tobycm/usb-charging-hub/usb-charging-hub.kicad_pcb

## KiCad design usb-charging-hub.kicad_pcb (2025-05-26)

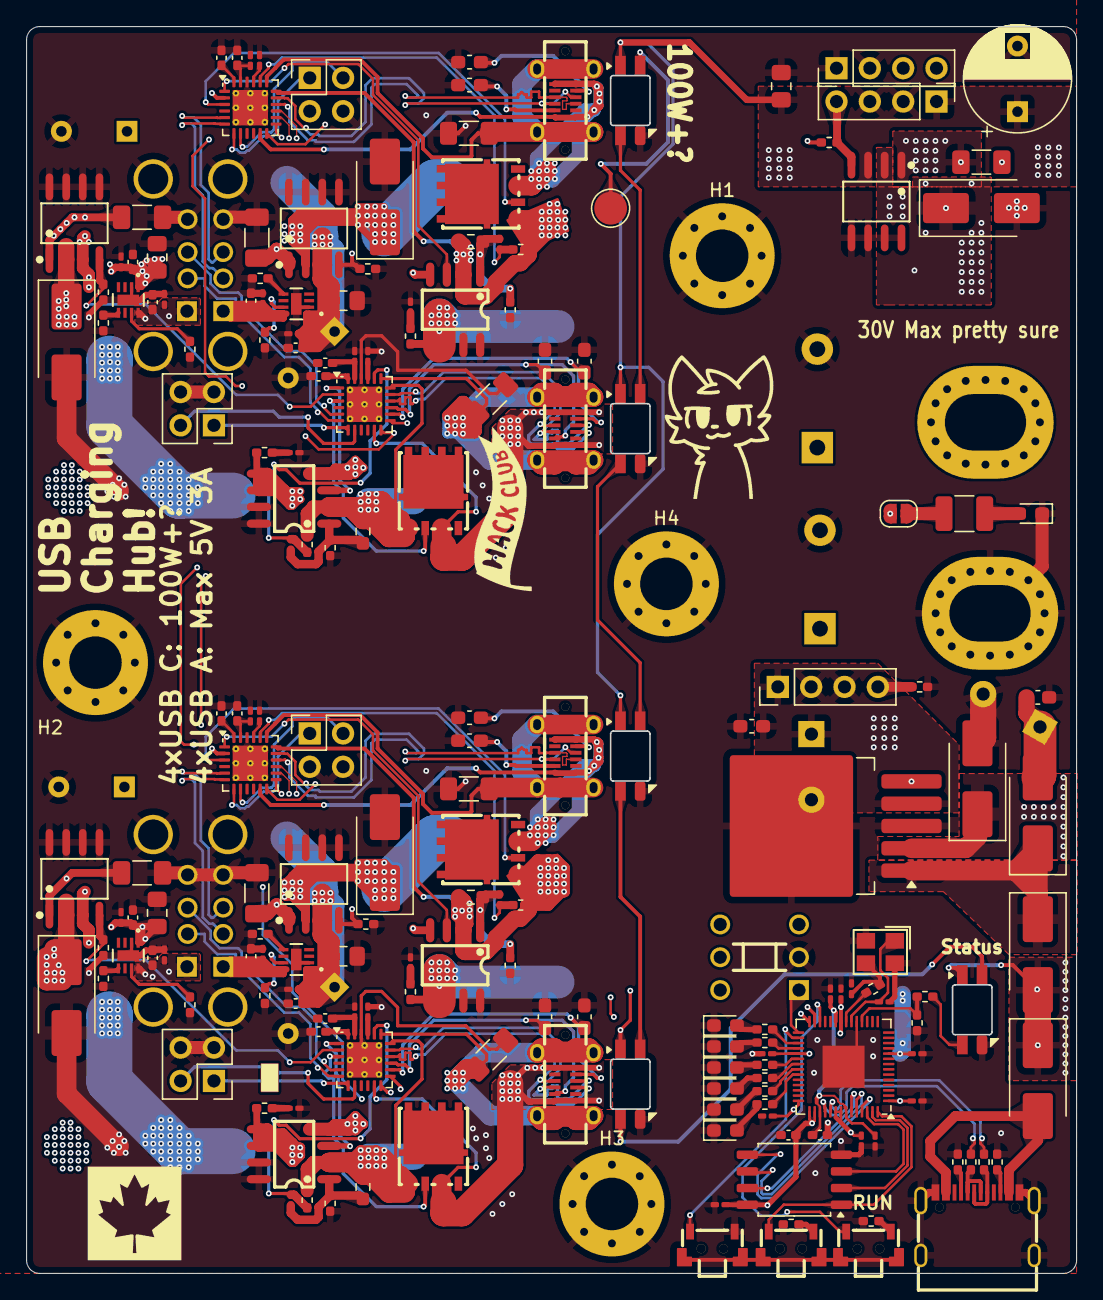
[picture p16: board usb-charging-hub.kicad_pcb from above]

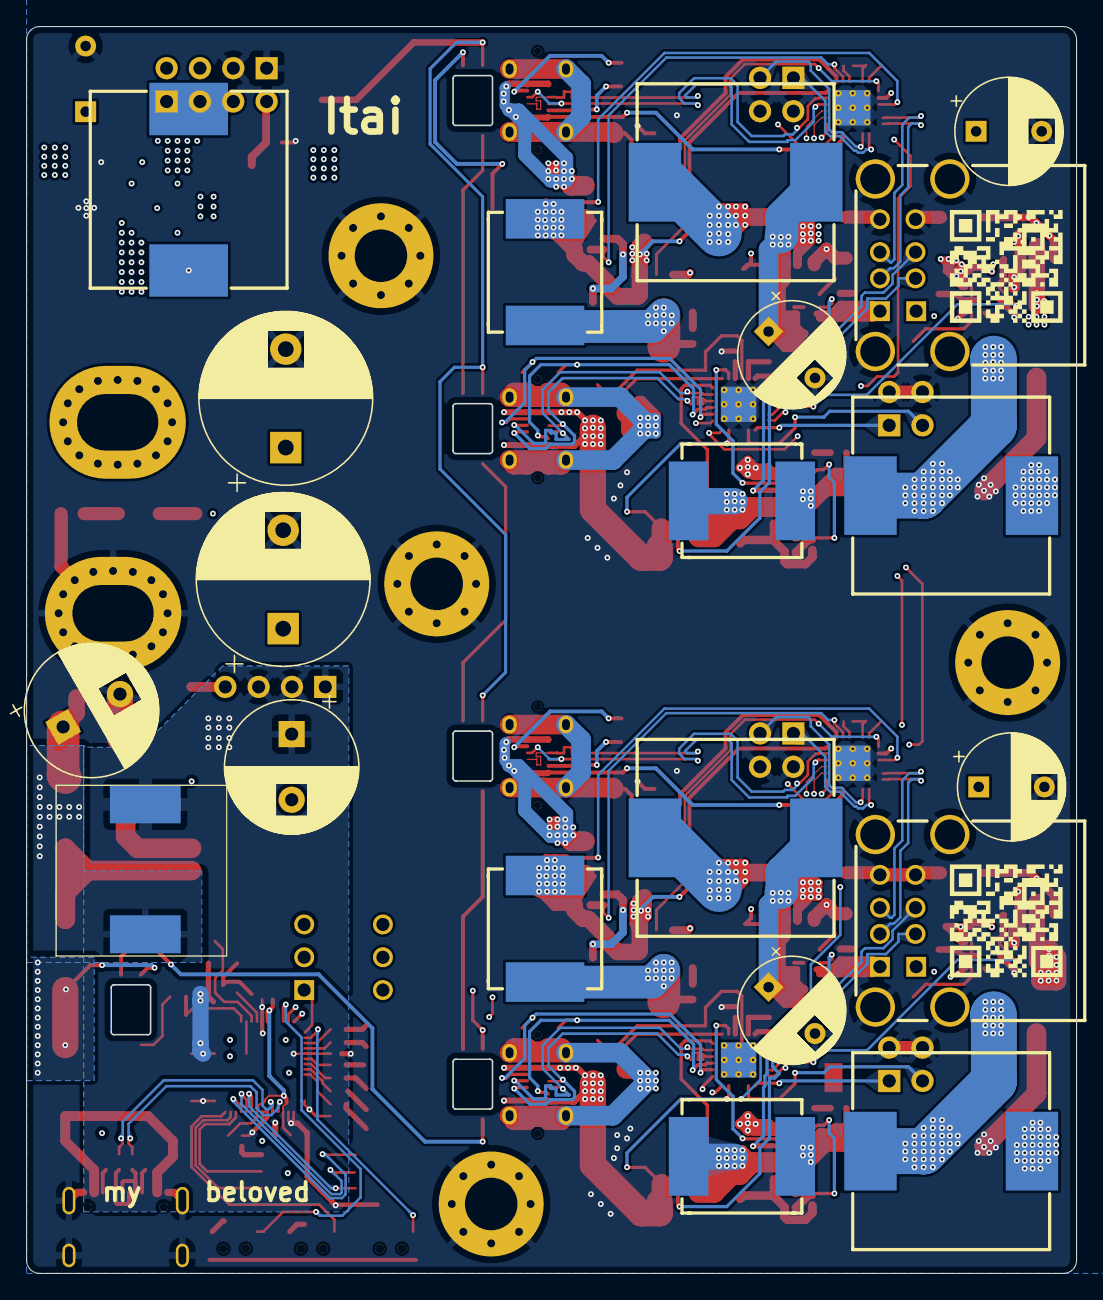
[picture p17: board usb-charging-hub.kicad_pcb from below]

Board: 4 copper layers, 80.0 x 95.0 mm, 214 parts (20 on the bottom side), 159 nets.

Parts:
C1, C2: 50V,1000uF; CP_Radial_D13.0mm_P7.50mm
C3, C4, C5, C7, C8, C9, C10, C11, C12, C29, C36, C38, C40, C42, C44, C45, C52, C59, C66, C68, C70, C72, C74, C75, C82: 100nF; C_0201_0603Metric_Pad0.64x0.40mm_HandSolder
C6, C13, C30, C31, C37, C39, C41, C43, C46, C47, C60, C61, C67, C69, C71, C73, C76, C77: 1uF; C_0402_1005Metric_Pad0.74x0.62mm_HandSolder
C14, C15: 18pF; C_0201_0603Metric_Pad0.64x0.40mm_HandSolder
C16: 50V,470uF; CP_Radial_D10.0mm_P5.00mm
C17: 50V,1uF; C_0603_1608Metric_Pad1.08x0.95mm_HandSolder
C18: 35V,470uF; CP_Radial_D10.0mm_P5.00mm
C19: 10V,10uF; C_0603_1608Metric_Pad1.08x0.95mm_HandSolder
C20, C23, C24, C53, C54: 50V,10uF; C_1206_3216Metric_Pad1.33x1.80mm_HandSolder
C21, C25, C27, C55, C57: 35V,180uF; CP_Radial_D8.0mm_P5.00mm
C22, C26, C28, C56, C58: 35V,22uF; C_0805_2012Metric_Pad1.18x1.45mm_HandSolder
C32, C33, C48, C49, C62, C63, C78, C79: 390pF 5% X7R; C_0603_1608Metric_Pad1.08x0.95mm_HandSolder
C34, C50, C64, C80: 100pF; C_0201_0603Metric_Pad0.64x0.40mm_HandSolder
C35, C51, C65, C81: 1nF; C_0201_0603Metric_Pad0.64x0.40mm_HandSolder
D1: LED; LED_0603_1608Metric_Pad1.05x0.95mm_HandSolder
D2, D3: Green; LED_0603_1608Metric_Pad1.05x0.95mm_HandSolder
D4, D9, D11, D12, D13, D14, D15, D16: 40V,10A; D_SMB_Handsoldering
D5, D6: Amber; LED_0603_1608Metric_Pad1.05x0.95mm_HandSolder
D7, D8: Red; LED_0603_1608Metric_Pad1.05x0.95mm_HandSolder
D10: 60V,10A; D_SMB_Handsoldering
H1, H2, H3, H4: MountingHole_Pad; MountingHole_4mm_Pad_Via
J1, J2: Conn_01x01_Pin; MountingHole_4.3x6.2mm_M4_Pad_Via
J4, J6, J7: Conn_01x04_Pin; PinHeader_1x04_P2.54mm_Vertical
J8, J11, J13, J16: TYPE-C 16PLT-H10.0; TYPE-C-SMD_USB4120-03-C
J9, J12, J14, J17: Conn_01x04_Pin; PinHeader_2x02_P2.54mm_Vertical
J10, J15: XDUF-0426-081_C18202150; USB-A-TH_XDUF-0426-081
J35: GT-USB-7010ASV; USB-C-SMD_G-SWITCH_GT-USB-7010ASV
JP1: SolderJumper_2_Open; SolderJumper-2_P1.3mm_Open_RoundedPad1.0x1.5mm
L1: 33uH,4.25A; SDRI129-330MT
L2, L3, L4, L7, L8: YPRH1508-680M; IND-SMD_L15.0-W15.0
L5, L6, L9, L10: 6.8uH,5.2A,8A(Isat); IND-SMD_L8.0-W8.0-1
LED1, LED2, LED3, LED4, LED5: SK6812MINI-E_C5149201; SK6812-MINI-E
Q1, Q2, Q3, Q4: PMOS; PDFN-8_L5.2-W5.9-P1.27-LS6.2-BL
R1: 1.5k; R_1210_3225Metric_Pad1.30x2.65mm_HandSolder
R2, R3: 5.1k; R_0402_1005Metric_Pad0.72x0.64mm_HandSolder
R4, R5: 27; R_0402_1005Metric_Pad0.72x0.64mm_HandSolder
R6, R11, R16, R22, R31, R38, R47: 1k; R_0402_1005Metric_Pad0.72x0.64mm_HandSolder
R9, R10, R12, R13, R14, R15, R107: 470; R_0402_1005Metric_Pad0.72x0.64mm_HandSolder
R17, R18, R19, R20, R35, R36: 100k; R_0402_1005Metric_Pad0.72x0.64mm_HandSolder
R21, R30, R37, R46: 40k; R_0603_1608Metric_Pad0.98x0.95mm_HandSolder
R23, R32, R39, R48: 6.8; R_0402_1005Metric_Pad0.72x0.64mm_HandSolder
R24, R27, R29, R33, R40, R43, R45, R49, R108: 10k; R_0402_1005Metric_Pad0.72x0.64mm_HandSolder
R25, R34, R41, R50: 5mOhm 1% Shunt; R_1206_3216Metric_Pad1.30x1.75mm_HandSolder
R26, R28, R42, R44: 249k; R_0402_1005Metric_Pad0.72x0.64mm_HandSolder
SW1, SW3, SW4: TS24CA; SW-SMD_TS24CA
SW2: Latching; SW-TH_6P-L8.0-W8.0-P2.50
TP1: TestPoint; TestPoint_Pad_D2.5mm
U1: W25Q32JVSS; SOIC-8_5.3x5.3mm_P1.27mm
U2: ABM8-272-T3_C20625731; CRYSTAL-SMD_4P-L3.2-W2.5-BL
U3: RP2040; QFN-56-1EP_7x7mm_P0.4mm_EP3.2x3.2mm
U4: LM2596S-3.3; TO-263-5_TabPin3
U5, U6, U7, U14, U15: XXL1509-5.0; SOIC-8_L4.9-W3.9-P1.27-LS6.0-BL
U8, U12, U16, U20: NDP23511KC; SOP-8_L4.9-W3.9-P1.27-LS6.0-BL
U9, U13, U17, U21: CYPD3175-24LQXQ; QFN-24-1EP_4x4mm_P0.5mm_EP2.7x2.7mm_ThermalVias
U10, U11, U18, U19: LS0505EVD22; LS0505EVD22_LTF

Connections:
3.3V_BUCK_EN: J4.4, R17.2, U4.5 (~ON/OFF)
5V_BUCK_EN: J6.4, R18.2, U5.4 (EN)
+1V1: C4.2, C5.2, C6.2, U3.23 (DVDD), U3.45 (VREG_VOUT), U3.50 (DVDD)
+3.3V: C3.2, C7.2, C8.2, C9.2, C10.2, C11.2, C12.2, C13.2, C18.1, C19.1, J4.1, J4.2, J4.3, L1.2, U1.8 (VCC), U3.1 (IOVDD), U3.10 (IOVDD), U3.22 (IOVDD), U3.33 (IOVDD), U3.42 (IOVDD), U3.43 (ADC_AVDD), U3.44 (VREG_IN), U3.48 (USB_VDD), U3.49 (IOVDD), U4.4 (FB)
+5V: C21.1, C22.1, D4.1 (K), D9.2 (A), J6.1, J6.2, J6.3, L2.2, LED1.1 (VDD), LED2.1 (VDD), LED3.1 (VDD), LED4.1 (VDD), LED5.1 (VDD), U5.3 (FB)
/USB 1/1_BUCK_EN: U8.3 (EN), U9.1 (P1.0)
/USB 1/1_D+: J8.A6 (DP1), J8.B6 (DP2), U9.17 (DP0/P3.0)
/USB 1/1_D-: J8.A7 (DN1), J8.B7 (DN2), U9.16 (DM0/P3.1)
/USB 1/2_BUCK_EN: U12.3 (EN), U13.1 (P1.0)
/USB 1/2_D+: J11.A6 (DP1), J11.B6 (DP2), U13.17 (DP0/P3.0)
/USB 1/2_D-: J11.A7 (DN1), J11.B7 (DN2), U13.16 (DM0/P3.1)
/USB 1/D_5V: C27.1, C28.1, C43.2, C44.2, L4.2, U7.3 (FB), U11.1 (IN)
/USB 1/D_BUCK_EN: R20.2, U7.4 (EN), U13.2 (P1.1)
/USB 1/D_D+: J10.7 (D-D+), U13.5 (DP1/P1.2)
/USB 1/D_D-: J10.6 (D-D-), U13.6 (DM1/P1.3)
/USB 1/D_EN: R29.1, U11.5 (EN)
/USB 1/U_5V: C25.1, C26.1, C39.2, C40.2, L3.2, U6.3 (FB), U10.1 (IN)
/USB 1/U_BUCK_EN: R19.2, U6.4 (EN), U9.2 (P1.1)
/USB 1/U_D+: J10.3 (U-D+), U9.5 (DP1/P1.2)
/USB 1/U_D-: J10.2 (U-D-), U9.6 (DM1/P1.3)
/USB 1/U_EN: R27.1, U10.5 (EN)
/USB 2/1_BUCK_EN: U16.3 (EN), U17.1 (P1.0)
/USB 2/1_D+: J13.A6 (DP1), J13.B6 (DP2), U17.17 (DP0/P3.0)
/USB 2/1_D-: J13.A7 (DN1), J13.B7 (DN2), U17.16 (DM0/P3.1)
/USB 2/2_BUCK_EN: U20.3 (EN), U21.1 (P1.0)
/USB 2/2_D+: J16.A6 (DP1), J16.B6 (DP2), U21.17 (DP0/P3.0)
/USB 2/2_D-: J16.A7 (DN1), J16.B7 (DN2), U21.16 (DM0/P3.1)
/USB 2/D_5V: C57.1, C58.1, C73.2, C74.2, L8.2, U15.3 (FB), U19.1 (IN)
/USB 2/D_BUCK_EN: R36.2, U15.4 (EN), U21.2 (P1.1)
/USB 2/D_D+: J15.7 (D-D+), U21.5 (DP1/P1.2)
/USB 2/D_D-: J15.6 (D-D-), U21.6 (DM1/P1.3)
/USB 2/D_EN: R45.1, U19.5 (EN)
/USB 2/U_5V: C55.1, C56.1, C69.2, C70.2, L7.2, U14.3 (FB), U18.1 (IN)
/USB 2/U_BUCK_EN: R35.2, U14.4 (EN), U17.2 (P1.1)
/USB 2/U_D+: J15.3 (U-D+), U17.5 (DP1/P1.2)
/USB 2/U_D-: J15.2 (U-D-), U17.6 (DM1/P1.3)
/USB 2/U_EN: R43.1, U18.5 (EN)
/rp2040/USB_D+: R4.2, U3.47 (USB_DP)
/rp2040/USB_D-: R5.2, U3.46 (USB_DM)
/rp2040/USB_R_D+: J35.A6 (DP1), J35.B6 (DP2), R4.1
/rp2040/USB_R_D-: J35.A7 (DN1), J35.B7 (DN2), R5.1
GND: C1.2, C2.2, C3.1, C4.1, C5.1, C6.1, C7.1, C8.1, C9.1, C10.1, C11.1, C12.1, C13.1, C14.1, C15.1, C16.2, C17.2, C18.2, C19.2, C20.2, C21.2, C22.2, C23.2, C24.2, C25.2, C26.2, C27.2, C28.2, C29.1, C30.1, C31.1, C32.2, C33.2, C35.2, C36.2, C37.1, C38.1, C39.1, C40.1, C41.1, C42.1, C43.1, C44.1, C45.1, C46.1, C47.1, C48.2, C49.2, C51.2, C52.2, C53.2, C54.2, C55.2, C56.2, C57.2, C58.2, C59.1, C60.1, C61.1, C62.2, C63.2, C65.2, C66.2, C67.1, C68.1, C69.1, C70.1, C71.1, C72.1, C73.1, C74.1, C75.1, C76.1, C77.1, C78.2, C79.2, C81.2, C82.2, D1.1 (K), D2.1 (K), D3.1 (K), D5.1 (K), D6.1 (K), D7.1 (K), D8.1 (K), D11.2 (A), D12.2 (A), D13.2 (A), D14.2 (A), D15.2 (A), D16.2 (A), H1.1, H2.1, H3.1, H4.1, J2.1, J7.1, J7.2, J9.3, J9.4, J10.4 (U-GND), J10.8 (D-GND), J10.9 (SHELL), J10.10 (SHELL), J10.11 (SHELL), J10.12 (SHELL), J12.3, J12.4, J14.3, J14.4, J15.4 (U-GND), J15.8 (D-GND), J15.9 (SHELL), J15.10 (SHELL), J15.11 (SHELL), J15.12 (SHELL), J17.3, J17.4, J35.1 (SHELL), J35.2 (SHELL), J35.3 (SHELL), J35.4 (SHELL), J35.A1B12 (GND), J35.B1A12 (GND), LED1.3 (GND), LED2.3 (GND), LED3.3 (GND), LED4.3 (GND), LED5.3 (GND), R2.2, R3.2, R11.1, R16.1, R17.1, R18.1, R19.1, R20.1, R24.2, R25.2, R26.2, R27.2, R28.2, R29.2, R33.2, R35.1, R36.1, R40.2, R41.2, R42.2, R43.2, R44.2, R45.2, R49.2, R50.2, R108.2, SW1.1, SW1.2, SW1.3, SW2.2, SW3.1, SW3.2, SW4.1, SW4.2, U1.4 (GND), U2.2 (GND), U2.4 (GND), U3.19 (TESTEN), U3.57 (GND), U4.3 (GND), U5.5 (GND), U5.6 (GND), U5.7 (GND), U5.8 (GND), U6.5 (GND), U6.6 (GND), U6.7 (GND), U6.8 (GND), U7.5 (GND), U7.6 (GND), U7.7 (GND), U7.8 (GND), U8.7 (RT), U8.8 (GND), U9.22 (GND), U9.25 (GND), U10.2 (GND), U10.9 (GND), U11.2 (GND), U11.9 (GND), U12.7 (RT), U12.8 (GND), U14.5 (GND), U14.6 (GND), U14.7 (GND), U14.8 (GND), U15.5 (GND), U15.6 (GND), U15.7 (GND), U15.8 (GND), U16.7 (RT), U16.8 (GND), U17.22 (GND), U17.25 (GND), U18.2 (GND), U18.9 (GND), U19.2 (GND), U19.9 (GND), U20.7 (RT), U20.8 (GND), U21.22 (GND), U21.25 (GND)
unnamed: C14.2, R6.1, U2.3
unnamed: C35.1, R23.2
unnamed: C51.1, R32.2
unnamed: C65.1, R39.2
unnamed: C81.1, R48.2
unnamed: D1.2 (A), R1.2
unnamed: D2.2 (A), R9.2
unnamed: D3.2 (A), R10.2
unnamed: D5.2 (A), R12.2
unnamed: D6.2 (A), R13.2
unnamed: D7.2 (A), R14.2
unnamed: D8.2 (A), R15.2
unnamed: D9.1 (K), D10.1 (K), U4.1 (VIN)
unnamed: D11.1 (K), L1.1, U4.2 (OUT)
unnamed: D12.1 (K), L2.1, U5.2 (OUTPUT)
unnamed: D13.1 (K), L3.1, U6.2 (OUTPUT)
unnamed: D14.1 (K), L4.1, U7.2 (OUTPUT)
unnamed: D15.1 (K), L7.1, U14.2 (OUTPUT)
unnamed: D16.1 (K), L8.1, U15.2 (OUTPUT)
unnamed: C33.1, J8.A5 (CC1), U9.15 (CC1)
unnamed: C32.1, J8.B5 (CC2), U9.14 (CC2)
unnamed: J8.0 (EH), J8.A1 (GND), J8.A12 (GND), J8.B1 (GND), J8.B12 (GND), R25.1, U9.19 (CSP)
unnamed: J9.1, U9.7 (P0.0/SWD_DAT_0)
unnamed: J9.2, U9.8 (P0.1/SWD_CLK_0)
unnamed: C41.2, C42.2, J10.5 (D-VCC), U11.8 (OUT)
unnamed: C37.2, C38.2, J10.1 (U-VCC), U10.8 (OUT)
unnamed: C49.1, J11.A5 (CC1), U13.15 (CC1)
unnamed: C48.1, J11.B5 (CC2), U13.14 (CC2)
unnamed: J11.0 (EH), J11.A1 (GND), J11.A12 (GND), J11.B1 (GND), J11.B12 (GND), R34.1, U13.19 (CSP)
unnamed: J12.1, U13.7 (P0.0/SWD_DAT_0)
unnamed: J12.2, U13.8 (P0.1/SWD_CLK_0)
unnamed: C63.1, J13.A5 (CC1), U17.15 (CC1)
unnamed: C62.1, J13.B5 (CC2), U17.14 (CC2)
unnamed: J13.0 (EH), J13.A1 (GND), J13.A12 (GND), J13.B1 (GND), J13.B12 (GND), R41.1, U17.19 (CSP)
unnamed: J14.1, U17.7 (P0.0/SWD_DAT_0)
unnamed: J14.2, U17.8 (P0.1/SWD_CLK_0)
unnamed: C71.2, C72.2, J15.5 (D-VCC), U19.8 (OUT)
unnamed: C67.2, C68.2, J15.1 (U-VCC), U18.8 (OUT)
unnamed: C79.1, J16.A5 (CC1), U21.15 (CC1)
unnamed: C78.1, J16.B5 (CC2), U21.14 (CC2)
unnamed: J16.0 (EH), J16.A1 (GND), J16.A12 (GND), J16.B1 (GND), J16.B12 (GND), R50.1, U21.19 (CSP)
unnamed: J17.1, U21.7 (P0.0/SWD_DAT_0)
unnamed: J17.2, U21.8 (P0.1/SWD_CLK_0)
unnamed: J35.A5 (CC1), R2.1
unnamed: J35.B5 (CC2), R3.1
unnamed: JP1.1 (A), R1.1
unnamed: L5.1, R23.1, U8.5 (SW), U8.6 (SW)
unnamed: L6.1, R32.1, U12.5 (SW), U12.6 (SW)
unnamed: L9.1, R39.1, U16.5 (SW), U16.6 (SW)
unnamed: L10.1, R48.1, U20.5 (SW), U20.6 (SW)
unnamed: LED1.2 (DOUT), LED2.4 (DIN)
unnamed: LED2.2 (DOUT), LED3.4 (DIN)
unnamed: LED3.2 (DOUT), LED4.4 (DIN)
unnamed: LED4.2 (DOUT), LED5.4 (DIN)
unnamed: LED5.2 (DOUT), TP1.1
unnamed: L5.2, Q1.1 (D), R21.1, R22.1, U8.2 (VSEN), U9.18 (VBUS_IN_DIS)
unnamed: Q1.2 (G), U9.3 (VBUS_P_CTRL)
unnamed: J8.A4 (VBUS), J8.A9 (VBUS), J8.B4 (VBUS), J8.B9 (VBUS), Q1.3 (S), U9.11 (VBUS_C_MON_DIS)
unnamed: L6.2, Q2.1 (D), R30.1, R31.1, U12.2 (VSEN), U13.18 (VBUS_IN_DIS)
unnamed: Q2.2 (G), U13.3 (VBUS_P_CTRL)
unnamed: J11.A4 (VBUS), J11.A9 (VBUS), J11.B4 (VBUS), J11.B9 (VBUS), Q2.3 (S), U13.11 (VBUS_C_MON_DIS)
unnamed: L9.2, Q3.1 (D), R37.1, R38.1, U16.2 (VSEN), U17.18 (VBUS_IN_DIS)
unnamed: Q3.2 (G), U17.3 (VBUS_P_CTRL)
unnamed: J13.A4 (VBUS), J13.A9 (VBUS), J13.B4 (VBUS), J13.B9 (VBUS), Q3.3 (S), U17.11 (VBUS_C_MON_DIS)
unnamed: L10.2, Q4.1 (D), R46.1, R47.1, U20.2 (VSEN), U21.18 (VBUS_IN_DIS)
unnamed: Q4.2 (G), U21.3 (VBUS_P_CTRL)
unnamed: J16.A4 (VBUS), J16.A9 (VBUS), J16.B4 (VBUS), J16.B9 (VBUS), Q4.3 (S), U21.11 (VBUS_C_MON_DIS)
unnamed: R11.2, SW3.3
unnamed: R16.2, SW4.3
unnamed: R34.2, U13.22 (GND), U13.25 (GND)
unnamed: R107.1, R108.1, U3.18 (GPIO15)
unnamed: SW2.1, U3.29 (GPIO18)
unnamed: SW1.4, U3.30 (GPIO19)
unnamed: R9.1, U3.31 (GPIO20)
unnamed: R10.1, U3.32 (GPIO21)
unnamed: R12.1, U3.34 (GPIO22)
unnamed: R13.1, U3.35 (GPIO23)
unnamed: R14.1, U3.36 (GPIO24)
unnamed: R15.1, U3.37 (GPIO25)
unnamed: C34.1, R21.2, R24.1, U8.1 (VFB)
unnamed: C36.1, U9.21 (COMP)
unnamed: C34.2, R22.2, U9.20 (FB)
unnamed: C31.2, U9.24 (VCCD)
unnamed: C29.2, C30.2, U9.23 (VDDD)
unnamed: R26.1, U10.7 (ILIM)
unnamed: R28.1, U11.7 (ILIM)
unnamed: C50.1, R30.2, R33.1, U12.1 (VFB)
unnamed: C52.1, U13.21 (COMP)
unnamed: C50.2, R31.2, U13.20 (FB)
unnamed: C47.2, U13.24 (VCCD)
unnamed: C45.2, C46.2, U13.23 (VDDD)
unnamed: C64.1, R37.2, R40.1, U16.1 (VFB)
unnamed: C66.1, U17.21 (COMP)
unnamed: C64.2, R38.2, U17.20 (FB)
unnamed: C61.2, U17.24 (VCCD)
unnamed: C59.2, C60.2, U17.23 (VDDD)
unnamed: R42.1, U18.7 (ILIM)
unnamed: R44.1, U19.7 (ILIM)
unnamed: C80.1, R46.2, R49.1, U20.1 (VFB)
unnamed: C82.1, U21.21 (COMP)
unnamed: C80.2, R47.2, U21.20 (FB)
unnamed: C77.2, U21.24 (VCCD)
unnamed: C75.2, C76.2, U21.23 (VDDD)
Pixels: LED1.4 (DIN), R107.2
QSPI_SCLK: U1.6 (CLK), U3.52 (QSPI_SCLK)
QSPI_SD0: U1.5 (DI/IO_{0}), U3.53 (QSPI_SD0)
QSPI_SD1: U1.2 (DO/IO_{1}), U3.55 (QSPI_SD1)
QSPI_SD2: U1.3 (~WP/IO_{2}), U3.54 (QSPI_SD2)
QSPI_SD3: U1.7 (~HOLD/~RESET/IO_{3}), U3.51 (QSPI_SD3)
QSPI_SS: SW3.4, U1.1 (~CS), U3.56 (QSPI_SS)
RUN: SW4.4, U3.26 (RUN)
SCL: U3.28 (GPIO17), U9.13 (P2.3), U13.13 (P2.3), U17.13 (P2.3), U21.13 (P2.3)
SDA: U3.27 (GPIO16), U9.12 (P2.2), U13.12 (P2.2), U17.12 (P2.2), U21.12 (P2.2)
VBUS: D4.2 (A), J35.A4B9 (VBUS), J35.B4A9 (VBUS)
VDC: C1.1, C2.1, C16.1, C17.1, C20.1, C23.1, C24.1, C53.1, C54.1, D10.2 (A), J1.1, J7.3, J7.4, JP1.2 (B), U5.1 (VIN), U6.1 (VIN), U7.1 (VIN), U8.4 (VIN), U12.4 (VIN), U14.1 (VIN), U15.1 (VIN), U16.4 (VIN), U20.4 (VIN)
XIN: C15.2, U2.1, U3.20 (XIN)
XOUT: R6.2, U3.21 (XOUT)
