tobycm/usb-charging-hub/(commit log)

2025-04-22 Init commit :D
    [usb-charging-hub.kicad_pcb, usb-charging-hub.kicad_sch]
2025-04-23 import settings from raver board
    [usb-charging-hub.kicad_pcb]
2025-05-15 bom is 90% finish, just smaller parts to be added if any finished rp microcontroller wiring, next is usb c ics and stuff
    [neopixels.kicad_sch, rp2350.kicad_sch, rp2350_power.kicad_sch, rp2350b.kicad_sch, ti_usb_c.kicad_sch, usb-charging-hub.kicad_pcb, usb-charging-hub.kicad_sch]
2025-05-15 fixed wrong wiring of 5V regulator for rp mcu + added all usb a ports
    [rp2350_power.kicad_sch, usb-charging-hub.kicad_sch, usba.kicad_sch, usba1.kicad_sch, usba2.kicad_sch, usba3.kicad_sch, usba4.kicad_sch, usba5.kicad_sch]
2025-05-17 gave up on single board, gonna make small modules
    [3.3v.kicad_sch, 5v.kicad_sch, neopixel.kicad_sch, rp2350_power.kicad_sch, rp2350b.kicad_sch, ti_usb_c.kicad_sch, usb-charging-hub.kicad_pcb, usb-charging-hub.kicad_sch]
2025-05-18 updated journal, pin headers footprint, etc. added labels to rp2350b, finished pcb routing. time to start on other modules yay
    [3.3v.kicad_sch, 5v.kicad_sch, neopixel.kicad_sch, rp2350b.kicad_sch, usb-charging-hub.kicad_pcb, usb-charging-hub.kicad_sch, usba.kicad_sch, usbc.kicad_sch]
2025-05-19 no more modules, its gonna work first try :fire: i love infineon and their ICs so much
    [3.3v.kicad_sch, 5v.kicad_sch, rp2040.kicad_sch, usb-charging-hub.kicad_pcb, usb-charging-hub.kicad_sch, usb1.kicad_sch, usb2.kicad_sch, usb3.kicad_sch]
2025-05-19 finished schematic yay!! now onto pcb routing :fire:
    [3.3v.kicad_sch, 5v.kicad_sch, neopixel.kicad_sch, neopixels.kicad_sch, rp2040.kicad_sch, rp2350.kicad_sch, rp2350_power.kicad_sch, rp2350b.kicad_sch]
2025-05-20 made huge progress today, finished wiring up the rp2040, finished one usb a and usb c layout :fire::fire::fire:
    [neopixels.kicad_sch, rp2040.kicad_sch, usb-charging-hub.kicad_pcb, usb-charging-hub.kicad_sch, usb1.kicad_sch, usb2.kicad_sch, usb3.kicad_sch, usb4.kicad_sch]
2025-05-25 holyyy i actually finished all of the bare pcb adding lots of art soon:tm:
    [neopixels.kicad_sch, rp2040.kicad_sch, usb-charging-hub.kicad_pcb, usb-charging-hub.kicad_sch, usb1.kicad_sch, usb2.kicad_sch, usb3.kicad_sch, usb4.kicad_sch]
2025-05-26 fix some errors and add some art :3
    [usb-charging-hub.kicad_pcb]
2026-04-25 update schematic
